AntonioPardo64/Interfono_Remoto/README.md

# Interfono_Remoto
Proyecto Interfono Remoto (TFG)
