AntonioPardo64/Interfono_Remoto/Circuito/interfonoRemoto/interfonoRemoto.ods

Reference | Quantity | Value
C1 C2 C3 | 3 | 1uF
C5 C4 | 2 | 100nF
C6 | 1 | 10uF
C7 | 1 | 10nF
D2 D3 D1 | 3 | 1N4001
D4 | 1 | LED
J1 | 1 | Screw_Terminal_01x05
J2 | 1 | Barrel_Jack_Switch
Q2 Q1 | 2 | BC240
R1 | 1 | 470R
R10 | 1 | 220R
R12 | 1 | 3K3
R3 R7 R2 R11 | 4 | 1K2
R4 | 1 | 600R
R5 R6 | 2 | 0R
R8 R9 R13 | 3 | 4K7
RV2 RV1 | 2 | 10K
SW1 | 1 | SW_Push
TR1 TR2 | 2 | ADT1-1
U2 | 1 | 4N28
U3 U1 | 2 | EC2-5NU
U4 | 1 | ESP32-DEVKITC-32D
U5 | 1 | w681360
