AntonioPardo64/Interfono_Remoto/Circuito/interfonoRemoto/mod3d/adt1_1.fcstd

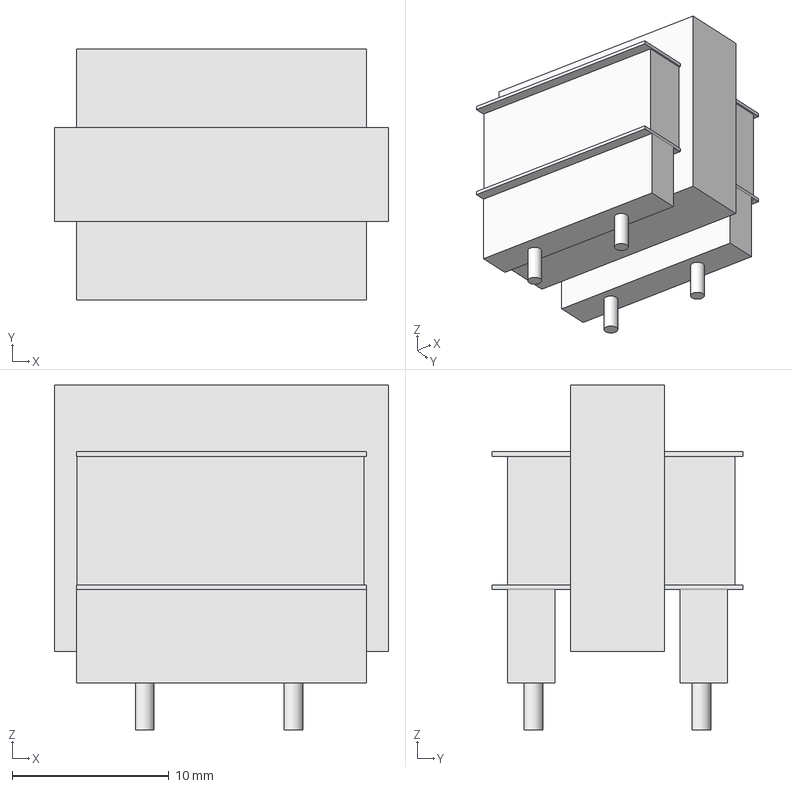
[picture p1: CAD file, 2020-07-18]
Circuito/interfonoRemoto/mod3d/adt1_1.fcstd
21.3 x 16.0 x 22.0 mm
