AntonioPardo64/Interfono_Remoto/Circuito/interfonoRemoto/mod3d/ec25nu.fcstd

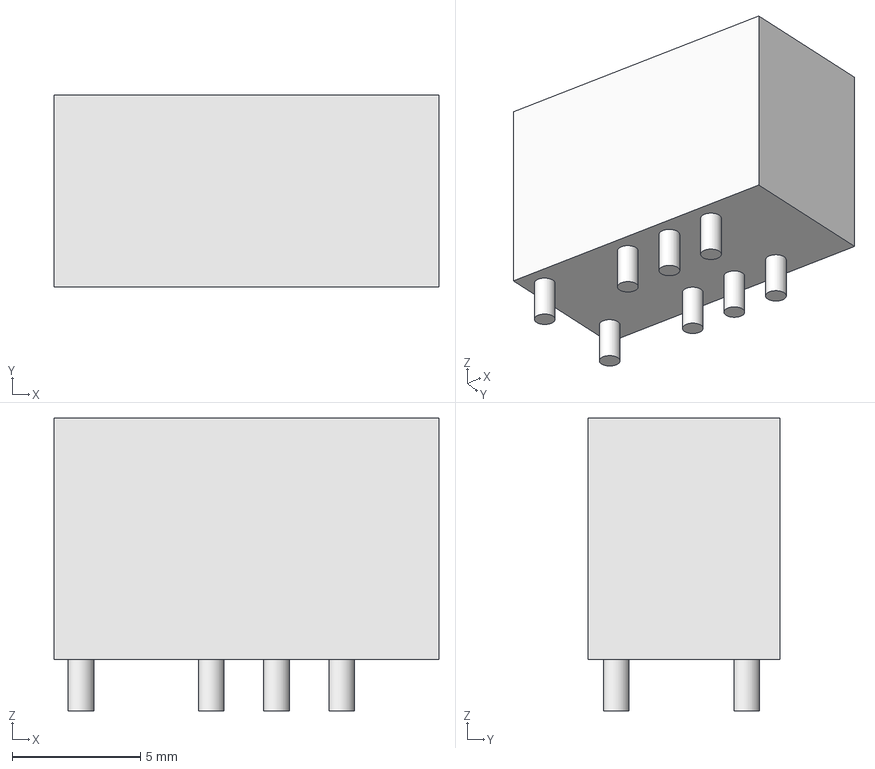
[picture p2: CAD file, 2020-07-18]
Circuito/interfonoRemoto/mod3d/ec25nu.fcstd
15.0 x 7.50 x 11.4 mm
