AntonioPardo64/Interfono_Remoto/Circuito/interfonoRemoto/mod3d/esp32.fcstd

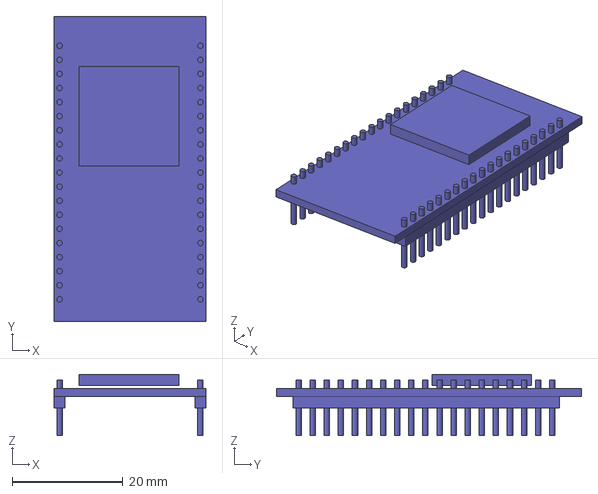
[picture p3: CAD file, 2020-07-18]
Circuito/interfonoRemoto/mod3d/esp32.fcstd
27.4 x 55.0 x 11.0 mm
