AntonioPardo64/Interfono_Remoto/Circuito/interfonoRemoto/mod3d/pulsador.fcstd

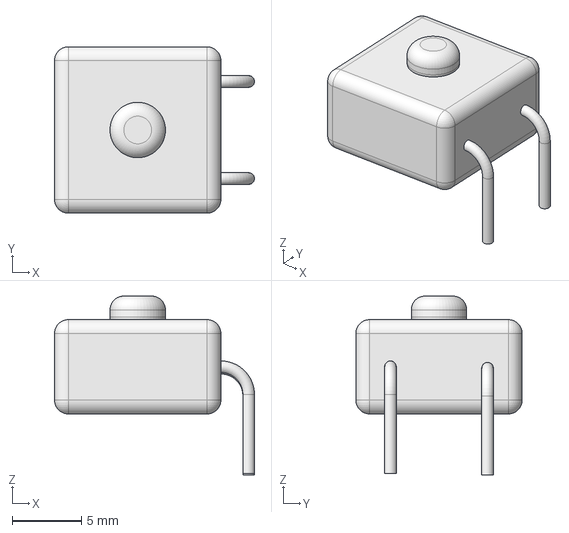
[picture p4: CAD file, 2020-07-18]
Circuito/interfonoRemoto/mod3d/pulsador.fcstd
14.4 x 12.0 x 12.9 mm
