AntonioPardo64/Interfono_Remoto/(list of files, drawings)

Other design files:
Circuito/interfonoRemoto/interfonoRemoto.dsn
