AntonioPardo64/Interfono_Remoto/Circuito/interfonoRemoto/interfonoRemoto.kicad_pcb

## KiCad design Circuito/interfonoRemoto/interfonoRemoto.kicad_pcb (2020-07-18)

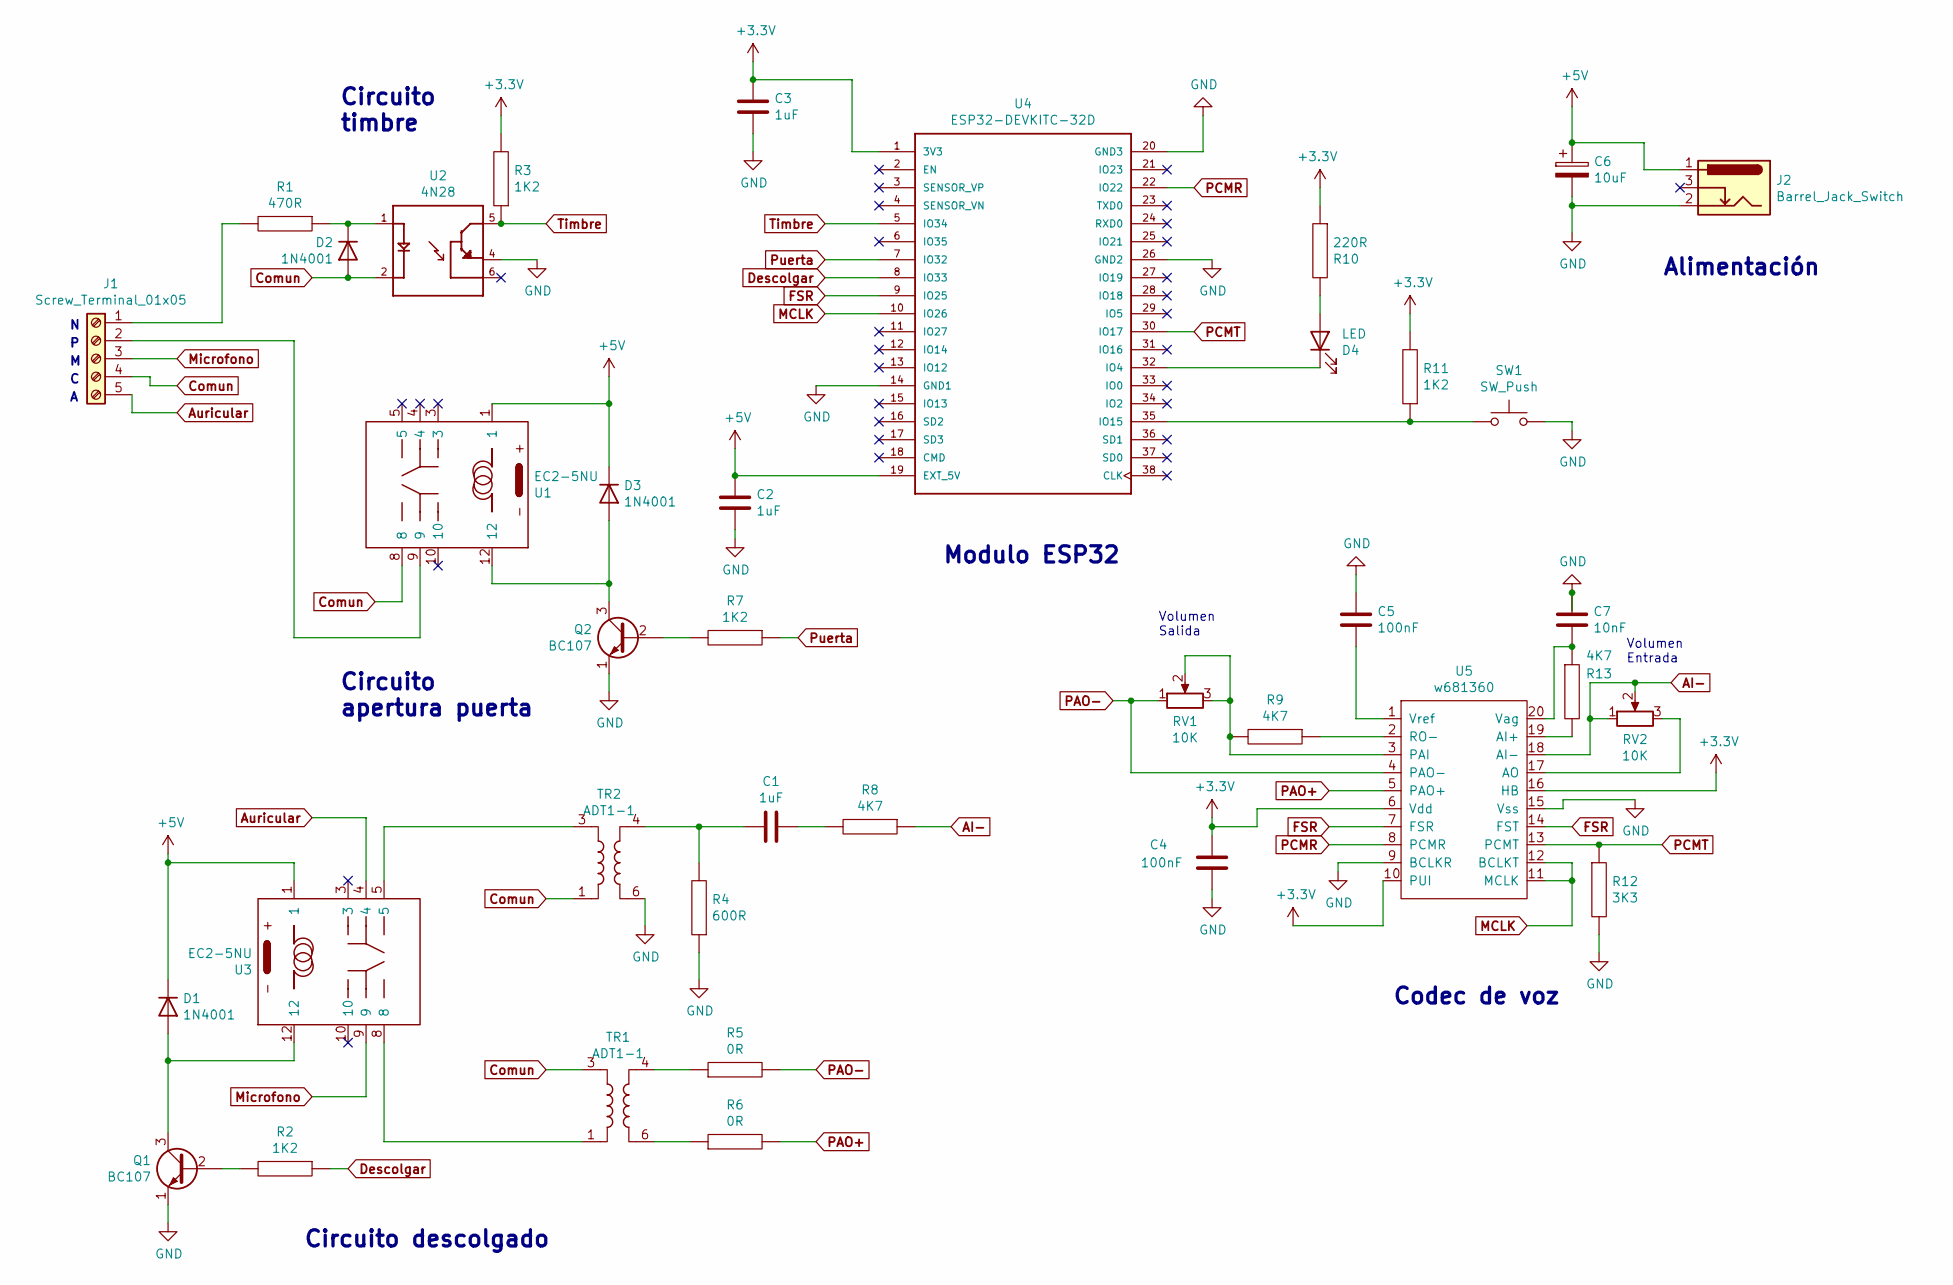
[picture p5: schematic interfonoRemoto.sch, Interfono Remoto]

Parts:
C1, C2, C3: 1uF; C_Rect_L7.2mm_W7.2mm_P5.00mm_FKS2_FKP2_MKS2_MKP2
C4, C5: 100nF; C_Disc_D4.7mm_W2.5mm_P5.00mm
C6: 10uF; C_Radial_D10.0mm_H16.0mm_P5.00mm
C7: 10nF; C_Disc_D4.7mm_W2.5mm_P5.00mm
D1, D2, D3: 1N4001; D_DO-41_SOD81_P10.16mm_Horizontal
D4: LED; LED_D3.0mm
J1: Screw_Terminal_01x05; conector_YO0521500000G
J2: Barrel_Jack_Switch; CUI_PJ-102A
Q1, Q2: BC107; TO-18-3
R1: 470R; R_Axial_DIN0207_L6.3mm_D2.5mm_P10.16mm_Horizontal
R2, R3, R7, R11: 1K2; R_Axial_DIN0207_L6.3mm_D2.5mm_P10.16mm_Horizontal
R4: 600R; R_Axial_DIN0207_L6.3mm_D2.5mm_P10.16mm_Horizontal
R5, R6: 0R; R_Axial_DIN0207_L6.3mm_D2.5mm_P10.16mm_Horizontal
R8, R9, R13: 4K7; R_Axial_DIN0207_L6.3mm_D2.5mm_P10.16mm_Horizontal
R10: 220R; R_Axial_DIN0207_L6.3mm_D2.5mm_P10.16mm_Horizontal
R12: 3K3; R_Axial_DIN0207_L6.3mm_D2.5mm_P10.16mm_Horizontal
RV1, RV2: 10K; Potenciometro
SW1: SW_Push; pulsador_Judco_50-0015-00
TR1, TR2: ADT1-1; Transformador_Tamura_TTC-105
U1, U3: EC2-5NU
U2: 4N28; Optoacoplador_DIP880W50P254L780H450Q6
U4: ESP32-DEVKITC-32D; MODULE_ESP32-DEVKITC-32D
U5: w681360; SSOP-20_W5.3mm

Connections:
+3V3: C3.1, C4.1, R3.2, R10.1, R11.2, U4.1 (3V3), U5.6 (Vdd), U5.10 (PUI), U5.16 (HB)
+5V: C2.1, C6.1, D1.1 (K), D3.1 (K), J2.1, U1.1, U3.1, U4.19 (EXT_5V)
AI-: R8.1, RV2.1, RV2.2, U5.18 (AI-)
Auricular: J1.5, U3.4
Comun: D2.2 (A), J1.4, TR1.3, TR2.1, U1.8, U2.2 (C_D)
Descolgar: R2.1, U4.8 (IO33)
FSR: U4.9 (IO25), U5.7 (FSR), U5.14 (FST)
GND: C2.2, C3.2, C4.2, C5.1, C6.2, C7.1, J2.2, Q1.1 (E), Q2.1 (E), R4.1, R12.2, SW1.2, TR2.6, U2.4 (E_T), U4.14 (GND1), U4.20 (GND3), U4.26 (GND2), U5.9 (BCLKR), U5.15 (Vss)
MCLK: U4.10 (IO26), U5.11 (MCLK), U5.12 (BCLKT)
Microfono: J1.3, U3.9
unnamed: C1.1, R8.2
unnamed: C1.2, R4.2, TR2.4
unnamed: C5.2, U5.1 (Vref)
unnamed: C7.2, R13.1, U5.20 (Vag)
unnamed: D1.2 (A), Q1.3 (C), U3.12
unnamed: D2.1 (K), R1.1, U2.1 (A_D)
unnamed: D3.2 (A), Q2.3 (C), U1.12
unnamed: D4.1 (K), U4.32 (IO4)
unnamed: D4.2 (A), R10.2
unnamed: J1.1, R1.2
unnamed: J1.2, U1.9
unnamed: Q1.2 (B), R2.2
unnamed: Q2.2 (B), R7.2
unnamed: R5.1, TR1.4
unnamed: R6.1, TR1.6
unnamed: R9.1, U5.2 (RO-)
unnamed: R9.2, RV1.2, RV1.3, U5.3 (PAI)
unnamed: R11.1, SW1.1, U4.35 (IO15)
unnamed: R13.2, U5.19 (AI+)
unnamed: RV2.3, U5.17 (AO)
unnamed: TR1.1, U3.8
unnamed: TR2.3, U3.5
PAO+: R6.2, U5.5 (PAO+)
PAO-: R5.2, RV1.1, U5.4 (PAO-)
PCMR: U4.22 (IO22), U5.8 (PCMR)
PCMT: R12.1, U4.30 (IO17), U5.13 (PCMT)
Puerta: R7.1, U4.7 (IO32)
Timbre: R3.1, U2.5 (C_T), U4.5 (IO34)

Notes on the sheet:
Volumen Salida
Volumen Entrada
Codec de voz
Modulo ESP32
Circuito descolgado
Circuito apertura puerta
Circuito timbre
Alimentación

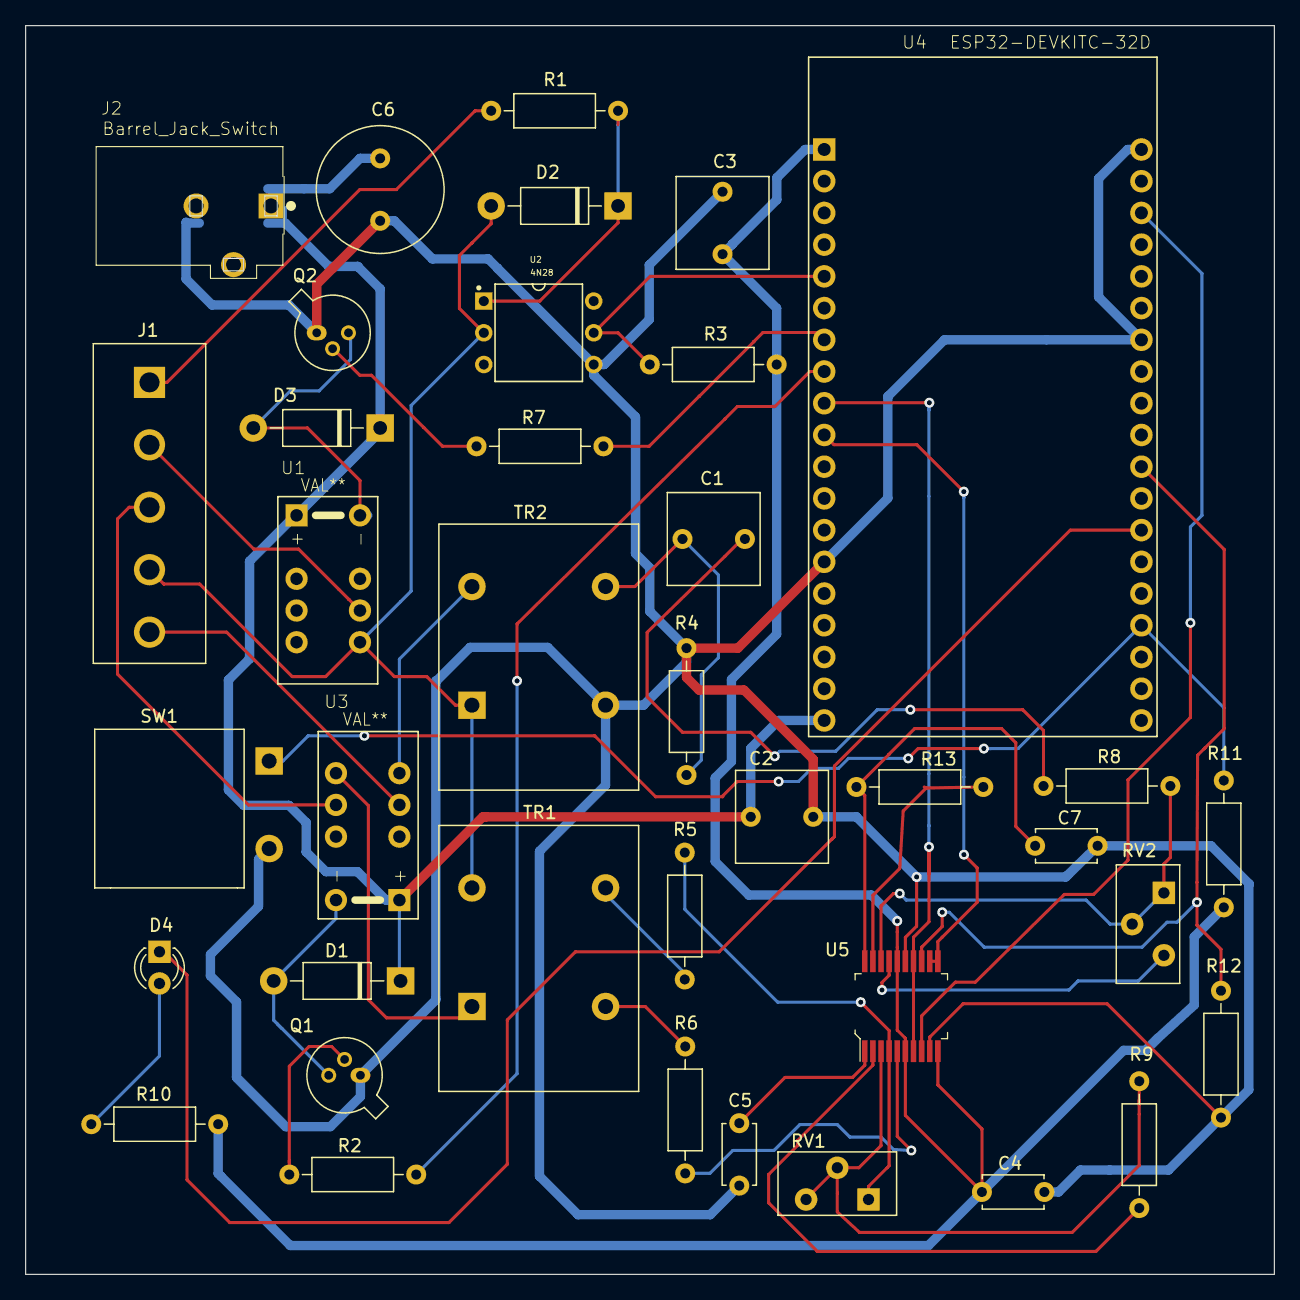
[picture p6: board interfonoRemoto.kicad_pcb from above]

Board: 2 copper layers, 100.0 x 100.0 mm, 38 parts (0 on the bottom side), 38 nets.
