AntonioPardo64/Interfono_Remoto/(commit log)

2020-07-18 Version Inicial.
    [adt1_1.fcstd, ec25nu.fcstd, esp32.fcstd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]
2020-07-20 Senalizacion de timbre.
